ECHAMBERP/gprs-davis-datalogger/hardware/pictures/station.jpg

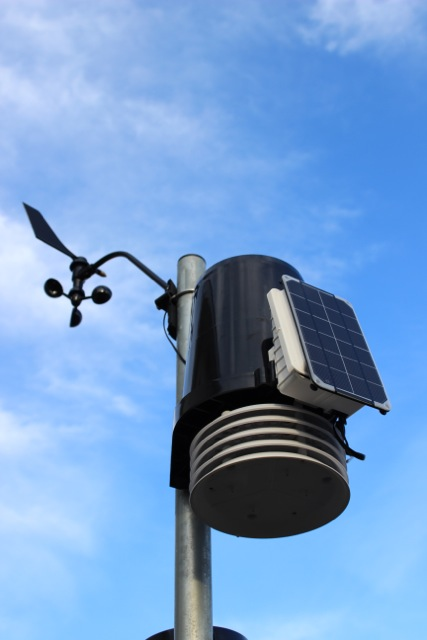
hardware/pictures/station.jpg
