ECHAMBERP/gprs-davis-datalogger/hardware/pictures/board.jpg

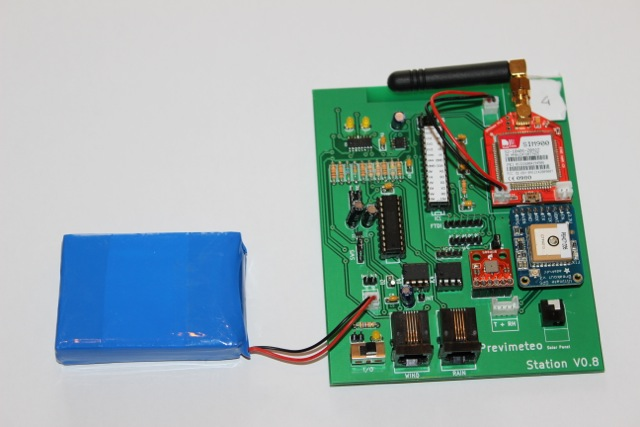
hardware/pictures/board.jpg
