ECHAMBERP/gprs-davis-datalogger/hardware/bill-of-materials.txt

### GPRS Davis sensors datalogger / bill of materials :

# Davis wind, rain and temperature / humidity sensors

- 1 x 6410 anemometer (new version with hall effect sensor)

- 1 x rain collector II (reconfigured for metric measurement)

- 1 x temperature & humidity sensor - based on the SHT1x sensor from Sensirion

- 1 x 6450 solar radiation sensor

# Modules : 

- 1 x BMP085 or BMP180 Barometric Pressure Sensor Breakout board (Sparkfun)

- 1 x Ultimate GPS Breakout board, version 3 (Adafruit)

- 1 x GPRSbee GSM/GPRS module with matching antenna (www.gprsbee.com)

# ICs :

- 1 x MCP73861 Li-Ion/Li-Po charge management controller (Microchip)

- 1 x TPS73233 3.3V Low Dropout Regulator (Texas Instruments)

- 1 x TC1014 3V Low Dropout Regulator (Microchip)

- 1 x ATMEGA328 DIP microcontroller (Atmel)

- 1 x MSP430G2553 DIP microcontroller (Texas Instruments)

- 1 x PCF8563 Real-time clock/calendar (NXP)

- 1 x 24LC1025 1024K TWI Serial EEPROM (Microchip)

- 1 x MAX4373 High-Side Current-Sense Amplifier & Comparator (Maxim Integrated)

# other components :

- crystals : 1 x 32.768Khz, 1 x 8MHz 

- connectors (JST and or DC / Jack, RJ11, RJ12)

- switches 

- resistors

- capacitors

- leds

# battery

- 3.7V 2000mAh (or more) Li-Ion battery

# solar panel

- 1W (or more) solar panel with maximum open-circuit voltage of 10 V (for example : large 6V / 3.4W solar panel from Adafruit)

# ATMEGA328 programming

The ATMEGA328 will have to be programmed, at first, with the Arduino Pro Mini 3.3V / 8MHz optiboot bootloader. 

You will need, for this, either a dedicated AVR ISP programmer or an "home made" one based on an ARDUINO module

(tutorial : http://letsmakerobots.com/node/35649)

When this will be done, A 3.3V FTDI cable (or an equivalent device) may be used to upload the sketches on the ATMEGA328.

We recommend you, in fact, to follow this option as it is the simplest and quickest way to upload the sketches on the board
from your computer and the Arduino IDE.

# MSP430G2553 programming

The MSP430G2553 can not (at this time) be programmed in situ on the board and thus requires the use of an external programmer.

The simplest and cheapest programmer usable with the ENERGIA IDE is the LAUNCHPAD MSP-EXP430G2, rev 1.5, from Texas Instruments.
