ECHAMBERP/gprs-davis-datalogger/firmware/msp430g2553/davis-wind-rain-meter-wiring.pdf

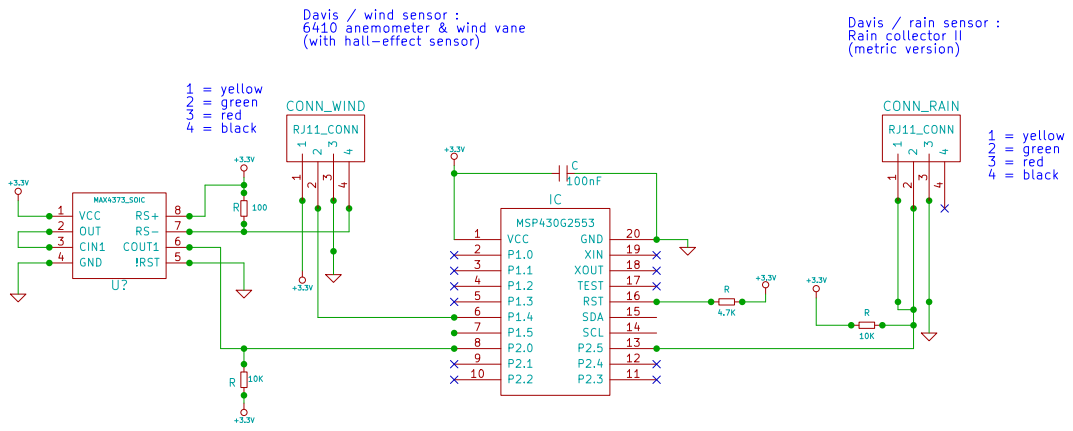
[picture p3: page 1]

Davis / wind sensor : 6410 anemometer & wind vane
(with hall-effect sensor)

RJ11_CONN Davis / rain sensor : Rain collector II (metric version)

Id: 1/1 Title: File: davis-wind-rain-meter.sch Sheet: /
