ECHAMBERP/gprs-davis-datalogger/(commit log)

2014-02-18 Addition of board and station pictures
2014-05-21 board schematics and firmware update
